carn181/hackgt-26/docs/SPEC.md

# C-HUD Vision — full build spec

> **Provenance.** This is the project `README.md` as of 2026-09-27, moved here verbatim when the README was
> rewritten for the HackGT 26 submission. **Section numbers are unchanged**, so the `§4.5`-style references
> scattered through code comments, commit messages and `prompts/` still resolve.
>
> Two of these sections are the *design* rather than the shipped state: §4.2–§4.4 (raw-audio packets on UDP
> `:7000`, telemetry `:7001`, LED commands `:7002`) describe the TDOA transport the hat was originally built
> for. The firmware that shipped instead reports an on-device direction guess — see `esp32/README.md` and the
> additive `hat_status` message. `server/` still implements and selftests the §4.2 packet path.
> Per-feature shipped/partial/not-built status lives in the README's status table.

---

# hackgt-26 — Wearable Sound-Awareness Cap

A cap with a 4-microphone array that finds **where** a sound came from, identifies **what** it is, and shows
both to a d/Deaf or hard-of-hearing wearer — direction on an LED strip on the brim, and a game-style HUD
overlay (bearing marker, class label, speech bubbles anchored to faces) on a phone/laptop camera view.

**Status: nothing built yet.** Timestamp of this revision: **Sat 2026-09-26 11:15 EDT**.

| Clock | |
|---|---|
| Hacking ends / submission deadline | **Sun 2026-09-27 08:00 EDT** (~21 h from this revision) |
| Expo + judging | Sun 09:00–11:15 |
| Code freeze | **Sun 05:00** (hard) |
| Hive (3D print / laser, PI-supervised) | **today 15:00–21:00 — the only window** |
| Fabrication dependency | **CAD (if any) must exist by 14:30** |

## Hardware on hand

| Part | Notes |
|---|---|
| 1× ESP32-S3 (+ 1× ESP32-C3 spare) | **Use the S3**: 4 mics need **2 I2S buses** (2 channels each). The C3 has one I2S port → 2 mics max. |
| **4× Adafruit ICS-43434 I2S mic breakouts** (PID 6049) | 1.6–3.6 V, 24-bit, bottom-ported, `SEL` pin picks L/R |
| Servo, PIR (HC-SR501), HC-SR04, WS2812 ring/strip, OLED | optional / stretch |
| Fifine lav (single TX) | **not part of the array** — wireless AGC + unknown latency ruin TDOA. Wearable-comparison prop only. |

---

## 0. Progress checklist

Owners: **A = `@____` (hat/ESP32) · B = `@____` (backend/models) · C = `@____` (frontend) · D = `@____` (integration)** — fill names in once.

**How this gets updated (agents: read before touching this file)**
1. Check a box **only after** you have run the evidence command and seen the expected result.
2. When checking, append your owner letter and time: `- [x] A2 … — A, 12:40`.
3. **Never uncheck, reword, or reorder another owner's item.** Append new items only at the end of your own section.
4. Dropped task → strike it and say why: `- [x] ~~A9 printed bar~~ — dropped: perfboard carrier is enough`.
5. Raw evidence (command + output) goes in `docs/`, not here. One item = one verifiable outcome.

Unchecked P0 items at the 04:00 acceptance run decide what the video is allowed to claim.

### A — Hat / ESP32
- [ ] A1 PlatformIO builds and flashes the S3 — evidence: serial boot line
- [ ] A2 **One bus, two mics** streaming per-channel RMS @10 Hz, both channels non-zero — evidence: serial log
- [ ] A3 Four mics on two buses enumerate, all four channels non-zero
- [ ] A4 Sample scaling correct (`>>16` of the 32-bit slot): silence ≈ tens of LSB, speech ≈ hundreds–thousands, no DC ramp — evidence: RMS log
- [ ] A5 Packetizer emits §4.2 packets at 50 pps/ch; `tools/udp_sniff.py` shows `magic=0xA14D`, `nch=4`, seq gaps < 0.1 %
- [ ] A6 **USB-CDC transport** streams the same packets (Expo insurance path) — evidence: sniff over serial
- [ ] A7 Telemetry @2 Hz with `rssi`, `dropped`, `pir`, `sonar_cm`
- [ ] A8 LED strip: lit position/hue equals commanded bearing within one frame
- [ ] A9 Hat assembled: bar straight, ports facing away from head, ≥5 mm standoff, strain relief, power bank balanced — evidence: photo in `docs/`
- [ ] A10 **Clap sign-flip test passes** (left vs right delays flip sign) — evidence: plot in `docs/`
- [ ] A11 Battery life ≥ 2 h while streaming both transports — evidence: measured
- [ ] A12 `esp32/HAT.md` committed: wiring map (bus→mic→SEL), pin assignments, known quirks

### B — Backend / models
- [x] B1 Model fetched, sizes match §8.1 — evidence: `ls -l models/` → 4126810 / 14096 bytes — B, 15:40
- [x] B2 `server/classify.py` implements the §8.2 API; startup logs path + sha256 + class count — B, 15:40 (live log: `yamnet models/yamnet.tflite sha256=10c95ea3… classes=521 rate=16000 window=15600`)
- [x] B3 §8.2 reproduction checks pass (sine → `Sine wave` ≈0.89, noise → not `Speech`, real speech > 0.7) — evidence: selftest output — B, 15:40 (`.venv/bin/python -m server.classify`: sine `Sine wave` 0.996; white `Static` 0.738; pink `Noise` 0.918; real speech 0.968–0.984; 8/8 checks PASS)
- [x] B4 Inference time recorded in `docs/` — B, 15:40 (5.65 ms mean per 0.975 s window, warm, XNNPACK CPU; `docs/backend-evidence.md`)
- [x] B5 `tools/udp_sniff.py` exists and prints packet stats (this unblocks A's A5) — B, 15:40 (`--selftest`: 150/150 packets, 50.0 pps, 0 gaps, per-channel RMS, exit 0)
- [x] B6 `server/ingest.py` reads UDP **and** serial into per-channel ring buffers; exposes seq-gap stats — B, 15:40 (`server.selftest --only udp`: 5/5 §4.2 packets, seq 0..4, per-channel levels round-trip; serial shares `parse_packet`, live over USB-CDC pending A6)
- [x] B7 GCC-PHAT on synthetic data within ±8° at −60/−30/0/+30/+60 — evidence: error table — B, 15:40 (`server.selftest --only doa`: laptop ±1.7°, hat (SRP) ±6.0°, both PASS)
- [x] B8 SRP-PHAT on live audio; `accuracy_deg` from measured spread; `ambiguous` flag set on 1-D ambiguity — B, 15:40 with a caveat: SRP verified on synthetic hat geometry (±6°), `accuracy_deg` comes from the measured sub-band spread, `ambiguous:true` on every 1-D result. **Live** audio DOA runs and correctly *refuses* on this laptop because its DMIC pair has no inter-channel baseline (README §6.2.1 note, `docs/backend-evidence.md` §4.2) — the code path is live, the geometry is not
- [x] B9 `backend_status` emitted on client connect + every 10 s with model sha256 + git rev — B, 15:40 (verified by `tools/latency_bench.py`: 2–3 `backend_status` + 9 `array_status` in a 16 s session)
- [ ] B10 Clap reaches a WS client as `sound_event` in < 1.5 s **with correct left/right sign** — the latency half is met (**onset→client p50 378 ms** measured on real speaker-played sound; sign flip verified synthetically at ±40° within 3°), but the *live* sign flip cannot pass on this laptop: its two DMIC channels have no inter-channel baseline (< ~5 mm, three methods in `docs/backend-evidence.md` §4.2), so the coherence gate correctly refuses to report an angle. `tools/latency_bench.py --inject-side flip` is the test to run on the hat
- [x] B11 `speech` message within 2 s of an utterance, text matches; name spotter works — B, 16:40: the live path works end to end (a 12.4 s ambient segment was transcribed live and emitted as `speech e63` with `parent_event` linked, on a worker thread; a controlled espeak-ng stimulus produced `Speech` at 44.6 dB SNR followed by a `speech` message). Word-level match and the name spotter are verified at module level; a *controlled* live text match needs a quiet room (this one has continuous ambient speech)
- [x] B12 Channel choice documented in code (P0 mid-pair → P1 steered beam); never a raw 4-ch sum — B, 15:40 (`server/beam.py`: P1 delay-and-sum steered to the bearing, P0 mean of the *widest* pair; no code path sums all channels)
- [ ] B13 `requirements.txt` installs clean into a **fresh** venv on a second machine — evidence: install log — not run on a second machine yet (fresh-venv install on this one succeeded, `import ai_edge_litert` OK without the §8.5 loader workaround)
- [x] B14 Latency bench exists and reports the three stages separately — B, 15:40 (`tools/latency_bench.py`: ping RTT p50 1.3 ms, backend onset→emit p50 378 ms, emit→client p50 2.3 ms, onset→client p50 378 ms, all on real speaker-played sound). It also **verifies the stimulus arrived** (`--require-snr-db`, exit 3 otherwise) and prints the A10 sign-flip verdict — a wrong measurement here once produced a false "broken microphone" diagnosis, and that guard is the fix for the whole class of error
- [x] B15 Camera path implemented: the HUD forwards face boxes, the backend fuses them into a bearing — B, 15:40 (§4.6 `vision`; `server/vision.py`, `fuse.localize`; README §4.5/§4.6 updated in the same commit)

### C — Frontend HUD
- [x] C1 App runs, camera opens, WS connects, `backend_status` (model + transport) rendered — C, 15:35
- [x] C2 Compass + markers render correctly from **fake events** (works before the backend is live) — C, 14:04
- [ ] C3 Marker lands within ±10 % frame width for claps at −40°/0°/+40°
- [x] C4 Edge chevrons when |bearing| > fov/2; `ambiguous:true` renders two mirrored candidates — C, 14:04
- [ ] C5 Face landmarks + mouth-open state; bubble anchored to the speaking face
- [ ] C6 Playback-vs-person: loudspeaker speech → marker with **no** face anchor, labelled playback
- [x] C7 Urgency tiers: `urgent` displaces other content; `set_mode` all/important/quiet works — C, 14:04
- [ ] C8 60 fps with camera running; added latency < 50 ms — evidence: measured number in `docs/`
- [ ] C9 Positions interpolate (no snapping); markers age and fade

### D — Integration, deliverables, gates
- [ ] D1 `docs/calibration.md` started with raw finger-to-keyboard logs
- [ ] D2 `config/calib.json` filled: spacing, inter-bus offset, head yaw, audio delay
- [ ] D3 Accuracy sweep done (−90…+90° step 15°, 5 trials): mean error + 1σ per bin
- [ ] D4 30-minute drift check recorded (t0 vs t+30 inter-bus offset)
- [ ] D5 04:00 full acceptance run: every P0 item above re-run and green
- [ ] D6 05:00 code freeze — tag `freeze`, no commits after except `docs/`
- [ ] D7 2-minute video recorded, six demo beats (§10), strip-only shot included
- [ ] D8 Devpost submitted: prior-art citation, accuracy curve, Notability screenshots, Create-X flag
- [ ] D9 Expo kit packed: charged power banks, USB tether, spare mic + wires, printed one-pager
- [ ] D10 Track chosen and stated in the submission (**Shipyard / Social Good / Lighthouse** — pick one)

### Hard gates (any owner may check these)
- [ ] G1 14:30 — decision made: printed parts in scope or not (CAD exists if yes)
- [ ] G2 18:00 — clap sign-flip passed (A10); if not, §9 cut order executes
- [ ] G3 01:00 — accuracy curve exists; if not, write-up claims only what is measured
- [ ] G4 04:00 — acceptance run; unchecked P0 items get cut from the video script
- [ ] G5 05:00 — freeze; 06:00 — video rendering; 08:00 — submitted

---

## 1. What we are building and why it isn't the 42nd version of this

The category ("sound awareness for DHH users") is well populated — see §11. Two prior projects explicitly left
our core claim as *future work*:

- **echoAI** (Qualcomm × LiteRT): *"our array consisted of a 1D line of closely spaced microphones… impossible
  to achieve greater than 1D localization."*
- **Low-latency Sound Disambiguator** (UB Hacking 2025): *"3D Spatial Localization: upgrade from 2D to full 3D
  using 3-4 microphone arrays with multilateration."*

One prior project is architecturally close to us: **HearLink** (4× I2S mics on 2 buses + ESP32-S3 + laptop +
YAMNet + beamforming, in a 3D-printed necklace) — but it is a **desk/necklace device**, not head-worn, and it
reports no accuracy numbers.

Our delta, in one sentence for the write-up:

> A **head-worn** array in the frame that actually matters (the wearer's own sense of direction), with measured
> accuracy, front/back resolved by **head rotation and head-shadow spectral cues**, and direction delivered
> through a **screen-free LED strip** so the wearer does not have to look at anything.

Three things we must do and say explicitly:
1. Report **measured** accuracy (claps at known angles, mean error + spread). Not a vibe.
2. Cite the prior art by name and state what we extend. Judges who know SoundWatch/HoloSound will check.
3. Ship the **screen-free direction output**. It is the part nobody has built, and it is what makes this a
   wearable rather than a laptop demo.

---

## 2. Constraints

| Constraint | Value |
|---|---|
| Submission rule | **One track only**; unlimited sponsor challenges |
| Track candidates (best fit first) | **Shipyard (Hardware)** — a wearable is squarely "smart devices", 1st prize = Meta Ray-Bans per member · **Social Good (Aramco)** — accessibility framing, likely least crowded · **Lighthouse (Immersive)** — only if the HUD is the hero |
| Free sponsor stacks | Notability (2 screenshots), Create-X (interest flag), SpaceXAI (build in Cursor / Grok Voice) |
| Unreachable from this project | Visa ($5k), Impiricus ($3k), Meta — wrong domains |
| Real work left | ~21 h wall, realistically ~15 h after food/sleep. **Scope accordingly (§9 ladder).** |

---

## 3. Architecture

```
   ┌──────────────────────── HAT ────────────────────────┐
   │  4× ICS-43434  (straight bar, 80 mm spacing)        │
   │    bus 0: mic0 (SEL=GND, L)  mic1 (SEL=3V3, R)      │
   │    bus 1: mic2 (SEL=GND, L)  mic3 (SEL=3V3, R)      │
   │  ESP32-S3 (crown, back)  WS2812 strip on brim       │
   └───────────┬─────────────────────────────┬───────────┘
               │ UDP :7000 PCM  (+USB-CDC     │ UDP :7001 telemetry
               │  fallback, same format)      │ ← :7002 aim/led commands
               ▼                              ▼
      ┌──────────────────────────────────────────────────┐
      │  backend (laptop)                                │
      │  ingest → ringbuf → GCC-PHAT/SRP-PHAT → bearing   │
      │  YAMNet → class   faster-whisper → text           │
      │  fusion → event stream                            │
      └──────────────────────┬───────────────────────────┘
                             │ WebSocket :8000/ws
                             ▼
      ┌──────────────────────────────────────────────────┐
      │  web (phone or laptop browser)                   │
      │  getUserMedia camera + MediaPipe faces           │
      │  HUD: bearing compass, markers, speech bubbles   │
      └──────────────────────────────────────────────────┘
```

### Latency budget (target ≤ 1.5 s)

| Stage | Budget | Measured |
|---|---|---|
| TDOA window / YAMNet window | 0.15 s / 0.975 s | — |
| Decision cadence (hop) | 0.25 s | — |
| YAMNet inference | < 50 ms | **2.4–2.9 ms** (reference only — reproduce per §8.2) |
| Whisper (2–4 s utterance) | 0.3–0.8 s | — |
| WS + render | < 50 ms | — |

### Frame of reference (read this twice)

Bearing is measured **in the hat frame** (0° = the wearer's nose). The camera is **in the hand/phone frame**.
Those differ. Three ways to handle it, in order of robustness:

1. **LED strip on the brim** — head-locked by construction, no alignment problem, no screen. **This is P0.**
2. **Phone held in front of the face** — one calibration constant (`head_yaw_offset_deg`) absorbs the
   difference; good to ~±15°. Fine for the demo, state the caveat honestly.
3. **Head-mounted display** (Quest passthrough, if one is at the hackathon hardware desk) — camera is
   head-locked by definition, `yaw_offset = 0`. P2, only if everything else is done.

---

## 4. Frozen interfaces

**Do not change these unilaterally.** If a change is required, edit this section in the same commit that changes
the code and say so in the commit message — a teammate may be mid-flight against the old shape.

### 4.1 Angle convention

- `bearing_deg`: **0° = straight ahead of the hat** (the wearer's nose). Positive = clockwise viewed from
  above = toward the wearer's right. Range `-180 … +180`.
- `elevation_deg`: `+` up; `null` until a vertical baseline exists (crown mic — P2).
- `accuracy_deg`: estimated 1-sigma error, **mandatory**. The HUD fades markers with it.
- Front/back ambiguity is a property of a linear array. It is resolved by (a) head rotation, (b) HF/LF energy
  ratio from head shadow, or (c) the camera. Never silently pick a half-space: report `bearing_deg` **and**
  the ambiguity flag.

### 4.2 Hat → backend: audio, UDP `:7000` (identical framing over USB-CDC)

Little-endian, one packet = one block for all channels:

```
offset  type    field
0       u16     magic     0xA14D
2       u8      version   1
3       u8      nch       channels (4)
4       u32     seq       packet counter, wraps
8       u64     t_us      ESP32 monotonic microseconds at first sample
16      u16     nsamp     samples per channel (320 = 20 ms)
18      i16[]   samples   channel-major, nch × nsamp, int16 (top 16 bits of the 24-bit mic word)
```

- 16 000 Hz, 320-sample blocks ⇒ 50 packets/s/ch ⇒ ~1.0 Mbit/s at 4 ch.
- No retransmission. `seq` gaps are measured, not hidden.
- **Transport is swappable by design:** the same packets go over WiFi UDP or USB serial. At Expo, in a hall
  with a thousand 2.4 GHz devices, **use USB**.

### 4.3 Hat → backend: telemetry, UDP `:7001` (2 Hz, JSON)

```json
{"type":"telemetry","t_us":123456789,"rssi":-52,"dropped":3,"pir":true,"sonar_cm":214,
 "battery_v":3.9,"cpu_c":41.2,"fw":"0.3","transport":"udp"}
```

### 4.4 backend → hat: commands, UDP `:7002` (JSON)

```json
{"type":"led","mode":"direction","deg":-37.5,"hue":210,"urgency":"normal"}
{"type":"led","mode":"off"}
{"type":"scan","from":-150,"to":150,"speed":90}
{"type":"aim","deg":-37.5}
```

### 4.5 backend → frontend: WebSocket `ws://127.0.0.1:8000/ws`

Every message carries `type` and `t` (seconds since backend start, monotonic).

```json
{"type":"sound_event","id":"e17","t":12.34,"class":"Speech","confidence":0.91,
 "bearing_deg":-37.5,"elevation_deg":null,"accuracy_deg":12,"ambiguous":true,
 "urgency":"normal","source":"array"}

{"type":"speech","id":"s3","t":12.9,"parent_event":"e17","bearing_deg":-35.0,
 "text":"did you see that","partial":false,"confidence":0.78,"lang":"en"}

{"type":"presence","t":12.9,"human":true,"source":"pir"}

{"type":"array_status","t":13.0,"mics":[{"id":0,"ok":true},{"id":1,"ok":true},
 {"id":2,"ok":false},{"id":3,"ok":true}],
 "calibration":{"baseline_m":0.24,"spacing_m":0.08,"head_yaw_offset_deg":0.0,
 "camera_fov_deg":62.0,"audio_delay_ms":18.0},"transport":"udp"}

{"type":"backend_status","t":0.2,"model":"yamnet","model_path":"models/yamnet.tflite",
 "model_sha256":"<sha256>","classes":521,"sample_rate":16000,"transport":"udp",
 "git_rev":"<short sha>"}   // emitted on client connect and every 10 s

{"type":"timeline","t":20.0,"events":[ /* recent sound_event / speech objects */ ]}
```

**Additive fields (owner B, 2026-09-26).** Implementations MAY attach extra keys; the HUD ignores
unknown keys, so these are not breaking. This backend currently adds:

| Where | Key | Meaning |
|---|---|---|
| `sound_event`, `speech` | `t_onset` | seconds since backend start of the first sample of the sound. This is what makes **onset → client** latency measurable instead of asserted (`tools/latency_bench.py`) |
| `sound_event` | `method` | `gcc-phat-pairs` \| `srp-phat` \| `vision` \| `camera-tiebreak` \| `none` — how the angle was obtained |
| `sound_event` | `delay_samples`, `snr_db`, `peak_db`, `alternatives` | diagnostics: the measured TDOA on the widest baseline, segment SNR, and the runner-up classes |
| `sound_event` | `name_heard` | set on a re-sent parent when the wearer's name was spotted in the transcript (id is unchanged, so the HUD updates in place) |
| `array_status.calibration` | `calibrated`, `profile`, `fit_spacing_m`, `fit_n` | whether the delay→angle scale is measured, which geometry is live, and the camera-referenced spacing fit behind it |
| `backend_status` | `source`, `asr`, `vision_frames`, `mode`, `noise_floor_db`, `events`, `latency` | the "why is nothing showing up" readout |

`source` ∈ `array` (acoustics only) · `array+vision` (camera resolved the half-space or supplied the
angle) · `vision` (camera only) · `none`. **`none` means nothing could localize the sound**: the class
is still real and useful, and `accuracy_deg` is 180 so the HUD fades the marker to nothing rather
than drawing a confident lie.

`urgency` ∈ `low | normal | high | urgent`; alarm/siren/smoke → `urgent`, and the HUD must let it displace
everything else (SoundWatch's top finding: **overload is the failure mode**).

### 4.6 frontend → backend: control, same socket

```json
{"type":"set_mode","mode":"all|important|quiet"}
{"type":"ping","t":1.0}
{"type":"vision","t":1.23,"faces":[{"xc":0.42,"w":0.12,"mouth":0.31,"mouthActive":true}]}
{"type":"audio","t":1.23,"rate":16000,"channels":1,"format":"pcm16","seq":42,"data":"<base64>"}
```

`ping` is answered **twice**, additively: with the verbatim echo (the original HUD measures RTT from
its own stamp, and the mock behaves the same) and with `{"type":"pong","t":<backend seconds>,"t_echo":<the
client's t>}`, which is what the reeves frontend's validator accepts. Either client gets a latency
readout; nothing breaks if a client ignores one of them.

`audio` (added by owner B, 2026-09-26, additive) makes the HUD's own microphone the backend's
input, so the **phone** can be the sensor when the laptop's mics are the weak part of the demo.
One message = one 20 ms frame of 16 kHz mono PCM16 (320 samples, 640 bytes, base64 in JSON,
~43 kB/s at 50 frames/s). The backend validates `rate`, `channels` and `format` against the live
profile and drops mismatched frames with a counted warning, so a stray 48 kHz stereo stream cannot
be silently interpreted as a different array.

Run it with `--profile browser_mono --source browser`. One capsule is not an array, so `pairs()` is
empty, DOA refuses, and the bearing still comes from `vision` — the class, the timing and the
transcript are what this path is for. The profile's band is wider than the laptop's (80–8000 Hz vs
300–6000) because a phone mic has no DC/LF junk to hide from and a clap's identifying energy is its
high-frequency snap.

`vision` (added by owner B, 2026-09-26, additive) carries the face observations the HUD already
computes, because **there is exactly one webcam and the browser owns it**: the backend cannot open
`/dev/video0` while the HUD streams it. Sent at ~10 frames/s while face tracking is `ready`.

- `xc` — face-box **centre** as a fraction of the camera frame width. This is the exact inverse of the
  frozen projection in §6.3: `bearing = atan((2·xc − 1)·tan(fov/2)) + head_yaw_offset_deg`.
- `w` — box width as a frame fraction, used for the bearing's error bar.
- `mouth` / `mouthActive` — MediaPipe `jawOpen` and the HUD's own hysteresis. A face whose mouth is
  moving is taken as the source of a speech-like sound; any visible face can break the linear array's
  front/back tie (README §4.1 resolution (c)).

Frames are aged out after 0.6 s: a face seen three seconds ago says nothing about a sound now. The
backend never sends face data back, and never trusts a face for anything except a bearing and
`presence`.

### 4.7 `config/array.json` — geometry single source of truth

Straight bar on the brim. Spacing 80 mm ⇒ total baseline 240 mm. Aliasing limit $c/2d$ = **2.1 kHz**
(better than a 200 mm desk array's 857 Hz); finer spacing costs delay resolution, so don't go below ~60 mm.

```json
{"rate_hz":16000,"layout":"line","spacing_m":0.08,"baseline_m":0.24,
 "mics":[{"id":0,"bus":0,"lr":"L","x":-0.12,"y":0.0,"z":0.0},
         {"id":1,"bus":0,"lr":"R","x":-0.04,"y":0.0,"z":0.0},
         {"id":2,"bus":1,"lr":"L","x": 0.04,"y":0.0,"z":0.0},
         {"id":3,"bus":1,"lr":"R","x": 0.12,"y":0.0,"z":0.0}],
 "inter_bus_offset_samples":[0,0,0,0],
 "head_yaw_offset_deg":0.0,"camera_fov_deg":62.0,"front_half_is":"nose"}
```

---

## 5. Repo layout and ownership

| Path | Owner | Contents |
|---|---|---|
| `esp32/` | **A** | PlatformIO firmware; wiring map; `esp32/HAT.md` build notes |
| `server/` | **B** | UDP/USB ingest, DOA, YAMNet, Whisper, fusion, WS |
| `web/` | **C** | Vite + TS: camera, HUD, bubbles |
| `config/` | **A** owns edits | `array.json`, `calib.json` |
| `docs/` | **D** | calibration log, accuracy curve, write-up, video script |
| `tools/` | shared | `udp_sniff.py`, angle plots, throwaway spikes |
| `models/` | B | gitignored; fetch per §8.2 |

Rules for everyone and their agents: touch only your globs; never reformat another owner's files; §4 changes
require a README edit in the same commit; `main` must stay runnable.

---

## 6. Workstream briefs (paste these into your coding agent)

> Scaffolding dirs are empty. Every script or module named below **does not exist yet — writing it is the
> deliverable**. Don't go looking for it.
>
> When one of your acceptance criteria passes, tick the matching box in **§0** with your owner letter and the
> time (`- [x] B7 … — B, 13:20`). That checklist is how the team knows what is real; keep it honest — an
> unticked box is worth more than a false one at 04:00.

### 6.1 Agent brief — ESP32 / hardware (member A)

> You are in `~/hackgt-26` during a 36-hour hackathon; ~20 h remain. Read §1, §3, §4, §7.1 of `README.md`
> first — §4 is frozen. You own `esp32/**` and `config/array.json`. Do not touch `server/**`, `web/**`, `models/**`.
>
> **Deliverable:** PlatformIO firmware for **ESP32-S3** that
> 1. captures **4× ICS-43434** as two stereo pairs: bus 0 = mics 0/1, bus 1 = mics 2/3, 16 kHz, 32-bit slots;
> 2. emits the §4.2 packets over **UDP** *and* over **USB-CDC serial** (same bytes, `--transport` build flag) —
>    the USB path is the Expo insurance policy;
> 3. emits §4.3 telemetry at 2 Hz; accepts §4.4 LED/scan commands;
> 4. drives the WS2812 strip so the lit position/hue equals the commanded bearing.
>
> **ICS-43434 specifics (do not re-derive):**
> - Pins: `3V` (1.6–3.6 V), `GND`, `BCLK`, `DOUT`, `LRCLK`, `SEL`. **3.3 V logic only — never 5 V.**
> - `LRCLK` low = left channel transmits, high = right. `SEL` low = left, `SEL` high = right.
> - The mic packs **24-bit signed samples left-justified in each 32-bit slot**, so the **top 16 bits of each
>   32-bit slot are already a signed int16** → configure 32-bit slots and `>> 16` (arithmetic) per sample.
>   Get this wrong and you get either silence or a −6 dB/octave mess that looks like "bad mics".
> - `BCLK` 2–4 MHz nominal: `2 ch × 32 bit × 16 kHz = 1.02 MHz` for one bus — slower than nominal but reliably fine.
> - Both mics on a bus **share BCLK/LRCLK/DOUT**; wire `SEL` to GND on one, 3V3 on the other. Five wires per bus total.
>
> **Acceptance, in order:**
> 1. **One bus first.** With only mics 0/1 wired, print per-channel RMS at 10 Hz: silence ≈ tens of LSB,
>    speech in a quiet room ≈ hundreds-to-thousands. Both channels must show signal.
> 2. `python3 tools/udp_sniff.py` (written by B) shows `magic=0xA14D`, `nch=4`, `seq` gaps < 0.1 %.
> 3. **Clap sign-flip test — the make-or-break test.** Clap left of the wearer, then right. The measured
>    inter-channel delays must **flip sign**. If they don't: geometry, `SEL` wiring, or `>> 16` is wrong.
>    Do not proceed to integration until this passes.
> 4. Strip lights the commanded bearing within one frame; serial transport streams at full rate.
>
> **Traps:** never power the array from the same rail as a servo (transients are audible and produce phantom
> detections); mount the bar so the **bottom ports face away from the head** (these are bottom-ported parts —
> the acoustic hole is under the PCB, on the side away from the solder pads); keep the bar ≥5 mm off the fabric
> (fabric+foam comb-filters the HF you need for TDOA); keep the S3's antenna clear of the head, the battery,
> and the brim.

### 6.2 Agent brief — backend, DSP and models (member B)

> Read §3, §4, §8 of `README.md`; §4 is frozen. You own `server/**`, `models/**`, `tools/**`.
>
> **Deliverable:** Python service: `tools/udp_sniff.py` (packet verifier, needed by A today),
> `server/ingest.py` (UDP **and** serial readers → per-channel ring buffers, seq-gap stats),
> `server/doa.py` (GCC-PHAT, then SRP-PHAT over a coarse grid), `server/classify.py` (YAMNet),
> `server/asr.py` (faster-whisper + name spotter), `server/fuse.py`, `server/main.py` (FastAPI + WS on :8000).
>
> **The classifier is a repo artifact you write, not something that already exists.** Get the model in place
> first (§8.1) and reproduce the §8.2 checks before writing DSP, so a wrong model file can never be mistaken
> for bad audio. Nothing outside this repo is a dependency.
>
> **Acceptance:**
> 1. `python -m server.selftest`: synthetic multichannel audio with a source at a known angle → recovered
>    within ±8° at −60/−30/0/+30/+60°. Prints the error table.
> 2. On files: `sine.wav` → `Sine wave`; white noise → `Static`/`Noise`; speech → `Speech` > 0.7.
> 3. Live: a clap reaches the WS client as a `sound_event` in < 1.5 s **with the correct left/right sign**.
> 4. A spoken sentence yields a `speech` message with matching text in < 2 s.
>
> **Traps:** band-limit to 300–6000 Hz and use SRP-PHAT — plain cross-correlation fails badly in a reverberant
> room, and reporting 40° errors as 5° loses the prize. Derive `accuracy_deg` from measured spread. Because the
> array is 1-D, emit `ambiguous:true` rather than guessing the half-space.

#### 6.2.1 Running the backend (owner B)

Python venv only; `tools/run_backend.sh` is the one documented entry point (it also handles the NixOS
loader-path quirk of §8.5, and is a plain pass-through everywhere else).

```bash
uv venv .venv && uv pip install -r requirements.txt   # once
tools/run_backend.sh                                  # defaults: --profile laptop_dmic --source auto
tools/run_backend.sh --source udp                     # the hat, once A is streaming §4.2
tools/run_backend.sh --source file --source-file x.wav # replay a recording at real time
tools/run_backend.sh --no-asr --print-events           # no Whisper; one line per event in the terminal
```

| Situation | Command |
|---|---|
| **The HUD's own mic (default for the demo)** | `--profile browser_mono --source browser` — just open the site, the page streams its mic |
| The hat (4 mics, `config/array.json` + measured `calib.json`) | `--profile hat` |
| This laptop's DMIC pair (stand-in array, no baseline) | `--profile laptop_dmic --source pw` |
| Auto-detect: listen on UDP :7000, fall back to the local mic after 2 s | `--source auto` |
| Latency, on a real sound played from the speakers | `.venv/bin/python tools/latency_bench.py --inject-side flip` |
| Sign-flip test (A10) on any array, no ESP32 needed | the same command — it prints `sign flip: OK/MISMATCH` |
| Why a clap reads as a fart | `.venv/bin/python tools/clap_lab.py --shots 5` (clap when prompted) |
| Speech detection alone, no HUD and no backend | `.venv/bin/python tools/speech_watch.py --local` |
| Verify the pipeline with no microphone at all | `.venv/bin/python -m server.selftest` |
| Watch §4.2 packets (the tool A5 needs) | `.venv/bin/python tools/udp_sniff.py --selftest` |

**The microphone is the website's, by default.** The HUD streams its own mic as §4.6 `audio`
frames; `?mic=0` turns it off, the **MICROPHONE** button toggles it and shows `MIC ON · Ns`.
This exists because the laptop's DMIC pair is a poor array: its two capsules are equally clean
in-band but channel 1 carries a 36%-of-full-scale DC offset and a sub-100 Hz rumble 31 dB above
channel 0's, and the pair has no inter-channel baseline. A phone has neither problem and is not
attached to the chassis, so a clap reaches it as airborne sound rather than a structural thump.

```bash
# laptop-only check (localhost is a secure context, nothing else needed)
tools/run_backend.sh --profile browser_mono --source browser   # terminal 1
cd web && npm run dev                                          # terminal 2 → http://localhost:5173/

# phone (needs HTTPS, because getUserMedia does)
cd web && PORT=5174 npm run phone      # prints https://<lan-ip>:5174/ and serves a cert
```
For the phone, install `web/.certs/caroot/rootCA.pem` once as a trusted certificate — with a
self-signed cert the phone browser treats the page as insecure and **blocks the microphone and
camera**. Android: Settings → Security → Encryption & credentials → Install a certificate → CA
certificate. macOS: Keychain Access → import → "Always Trust". Without that, the fallback is
`http://<lan-ip>:5173/` plus Chrome's `chrome://flags/#unsafely-treat-insecure-origin-as-secure`
entry for that origin.

- **`--fit-spacing write`** (default) measures the array's effective spacing against the camera while
  someone talks, and persists it into `server/profiles/<name>.json`. `config/calib.json` stays owner D's.
- **Measured on this laptop (2026-09-26, corrected):** the capture path is *fine* — the DMIC is
  `S32_LE @ 48 kHz`, a speaker-played 650 Hz tone arrives at **41 dB in-band SNR**, and live speech
  classifies as `Speech` at 44.6 dB SNR. Channel 1 carries a 16 %-of-FS DC offset and ~12 dB more LF
  energy, which is why the analysis band-pass is required (a clap rises 5.6 dB unfiltered vs 26 dB
  filtered). The genuine limitation is that the two channels have **no inter-channel baseline**
  (< ~5 mm, three independent methods), so azimuth cannot be recovered from this pair and the
  coherence gate refuses to invent one; the sign-flip test therefore cannot pass here. Nothing in the
  DSP is affected — the hat's 240 mm baseline is a real baseline. Details and raw numbers in
  `docs/backend-evidence.md`.

### 6.3 Agent brief — frontend HUD (member C)

> **Session starter:** paste `prompts/frontend.md` as the first message of a fresh session — it is this brief
> plus the paste-ready prompt (scope, contract, render rules, build order, evidence requirements).
>
> Read §3, §4.5, §4.6 first. You own `web/**`.
>
> **Deliverable:** Vite + TS app that opens the camera, connects to `ws://127.0.0.1:8000/ws`, and renders a
> game-HUD overlay: bottom bearing compass, per-event direction markers, class + confidence + urgency labels,
> and — for `speech` — **bubbles anchored to the face that produced them**. Markers fade with `accuracy_deg`,
> low-urgency events collapse, `urgent` displaces everything.
>
> **Camera ↔ bearing mapping (hat frame → camera frame):**
> ```ts
> // 0° = hat nose; head_yaw_offset_deg = calibration constant between hat-forward and camera-forward
> const b = toRad(bearing_deg - calib.head_yaw_offset_deg);
> const x = 0.5 * (1 + Math.tan(b) / Math.tan(toRad(calib.camera_fov_deg / 2)));
> const px = x * canvas.width;   // clamp; if |b| > fov/2 draw a chevron at the edge instead
> ```
> Faces: MediaPipe Tasks Vision `FaceLandmarker` — face box **and** mouth-open state; the mouth signal is what
> separates a person from a loudspeaker, which is a required demo beat.
>
> **Acceptance:**
> 1. Claps at −40°/0°/+40° put the marker under the matching real-world position (±10 % frame width).
> 2. Speech → bubble anchored to the speaker's face; a speaker playing speech → marker with **no** face anchor.
> 3. 60 fps overlay, < 50 ms added latency (echo `t` back and compare with `performance.now()`).
> 4. `set_mode:important` suppresses low-urgency; `quiet` shows only `high`+.
>
> **Traps:** camera needs a secure context — `localhost` or a self-signed HTTPS origin; **iOS Safari has no
> WebXR** (Android Chrome/desktop are fine). Interpolate positions — events arrive at 2–4 Hz and will jump.
> `ambiguous:true` events should render as two mirrored candidates, not one arbitrary choice.

#### 6.3.1 Running the HUD (owner C)

Everything lives in `web/`. Node + npm only (no bun/pnpm/yarn). Measured numbers and the exact evidence for
C1–C9 are in **`web/dev/evidence.md`**.

```bash
cd web
npm install                # also copies the MediaPipe WASM assets (postinstall)

# terminal 1 — mock backend, speaks the frozen §4.5 stream on 127.0.0.1:8000/ws
npm run mock

# terminal 2 — the app
npm run dev                # http://localhost:5173   (camera works: localhost is a secure context)
```

| Situation | Command / action |
|---|---|
| Laptop, camera + HUD | `npm run dev` → `http://localhost:5173`, click **Start camera** |
| Phone (needs HTTPS for the camera) | `npm run phone` → prints `https://<lan-ip>:5173/`; import the printed CA on the phone **once**, then open that URL |
| Phone, no camera needed | `npm run dev -- --host 0.0.0.0` → `http://<lan-ip>:5173` (the HUD renders; `getUserMedia` stays blocked) |
| Real backend instead of the mock | nothing to change — the backend just has to listen on `ws://127.0.0.1:8000/ws`; the HUD proxies `wss://<host>/ws` to it |
| Different socket | `?ws=` is honoured exactly, e.g. `?ws=ws://192.168.1.20:8000/ws` (from an **https** page it must be `wss://`; plain `ws://` is blocked as mixed content and the HUD says so) |
| Production build | `npm run build` (tsc + Vite) · `npm run preview` |

- **Start order does not matter.** `npm run mock` can be started later; the HUD retries with 0.5/1/2/4/8 s
  backoff, keeps rendering, and recovers on its own. If a backend restarts and resets its `t` clock, the HUD
  resyncs instead of discarding the new events.
- **The top-right chip** is the diagnostics readout: `state · model · transport · revision · mic health`.
  Tap it for model path + SHA, git rev, transport, every mic, calibration, presence, rolling 5 s FPS,
  ping-echo latency, face-tracking state and the event counters.
- **Scripted debug hooks** (read-only): `window.__hud.snapshot()`, `window.__hud.ws()`,
  `window.__hud.vision()`.
- **`npm run mock` replays**: two `low` + one `high` event (tier controls), `Clapping` −40° (ambiguous),
  `Speech` +10° with a partial→final transcript, a playback `Speech` −25° with no speaker, a moving id
  (−10°→+10° every 250 ms, for interpolation), and an `urgent` `Alarm` +120° that displaces everything.
  Its model/revision values are marked `MOCK`; geometry comes from `config/array.json`.
- **TLS env vars**: `TLS_CERT_FILE` + `TLS_KEY_FILE` together enable HTTPS, otherwise the dev server stays on
  HTTP. Setting only one is a startup error, not a silent fallback. `web/.certs/` (from `npm run phone`) is
  gitignored — never commit the leaf or the CA key.

### 6.4 Integration owner (member D)

Owns `docs/`, hat assembly, the calibration log, the accuracy curve, the Devpost write-up, the 2-minute video,
and the final merge. Runs the full acceptance test at **04:00 Sunday**, freezes the repo at **05:00**.

---

## 7. Hardware

### 7.1 Hat build (do this before anything aesthetic)

| Concern | Decision |
|---|---|
| Array | **Straight bar, 4 mics, 80 mm spacing (240 mm baseline)**, in front of the brim. A curved arc breaks the linear TDOA formula — keep it straight. |
| Port direction | ICS-43434 is **bottom-ported**: acoustic hole is on the far side from the solder pads. Mount so ports face **away from the head**, bar standing ≥5 mm off the fabric. |
| Mid-build carrier | Strip of perfboard + hot glue. **Do not put the Hive on the critical path** — the printed bar/shell is a P1-P2 nicety, not a dependency. |
| Wiring | 5 wires per bus (BCLK, LRCLK, DOUT, 3V, GND) shared by both mics on that bus; 30 AWG silicone wire; strain-relieve at the board. |
| Power | Small 5 V power bank in the crown at the back; S3 regulator to 3V3 for the mics. Balance the hat, or the brim droops. |
| RF | 2.4 GHz is absorbed by the body and jammed at Expo. Antenna up and outward, and **test the USB tether early**. |
| Wind / fabric | Foam windscreen over the bar; a bare MEMS port against fabric hears only the wearer's scalp and clothing noise. |
| Stretch | 5th mic on the crown for a vertical baseline (elevation). WS2812 strip on the brim is P0 output. |
| Explicitly not | A servo on the head: heavy, noisy (it injects into the mics), and unnecessary once the strip is the display. Keep the servo for a desktop variant only. |

### 7.2 Calibration (write results into `config/calib.json`)

1. **Baseline.** Measure actual mic-to-mic distance; set `spacing_m` / `baseline_m`. Never trust CAD.
2. **Inter-bus offset.** Clap at 0°; cross-correlate bus 0 vs bus 1; store the sample offset.
3. **Head yaw offset.** Point the camera at a source; store `head_yaw_offset_deg = measured_bearing`.
4. **Accuracy curve — this is our delta.** Claps at −90…+90° in 15° steps, 5 trials each: plot measured vs
   actual, record mean absolute error and 1-sigma per bin. Cold-start vs 30-minute-later run (drift check).
5. **Audio/vision offset.** Clap while the camera sees it; record `audio_delay_ms`.

---

## 8. Models and environment — repo-side setup

**Nothing on anyone's personal machine counts as setup.** The model, the loader code, and the venv are repo
artifacts. A fresh clone plus §8.1 has to be enough to run the backend on any of the four laptops.

### 8.1 Model fetch (do this first, it is a blocking dependency)

```bash
mkdir -p models
# The canonical storage.googleapis.com URL for this model returns 403. This tfhub.dev URL is the one that
# actually works (verified). Do not "fix" it back to the googleapis one.
#
# UPDATE (owner B, 2026-09-26 16:40): this tfhub.dev URL now returns **404** as well (checked with
# `curl -sIL`), so a fresh clone cannot fetch the model at all. Per the paragraph below, the model is
# therefore **committed to this repo** (force-added past the `models/` gitignore rule) — a fresh clone
# plus `uv pip install -r requirements.txt` is enough to run the backend. The class map still fetches
# fine from the raw.githubusercontent URL.
curl -L -o models/yamnet.tflite \
  "https://tfhub.dev/google/lite-model/yamnet/classification/tflite/1?lite-format=tflite"
curl -L -o models/yamnet_class_map.csv \
  "https://raw.githubusercontent.com/tensorflow/models/master/research/audioset/yamnet/yamnet_class_map.csv"
ls -l models/    # expect 4126810 bytes for the .tflite, 14096 for the CSV
```

`models/` is gitignored, **except the two files themselves, which are committed** (see the update in
§8.1 — both documented URLs are dead now). If you re-add them, commit both (4.1 MB total):
an unavailable model blocks three of four workstreams, and a binary in git is the cheaper problem.

### 8.2 Model interface contract (frozen — implemented in `server/classify.py`, owner B)

| Item | Value |
|---|---|
| Input tensor | `waveform_binary`, shape `(15600,)`, float32 in −1..1 |
| Sample rate | **16 kHz mono — identical to our capture rate, so nothing resamples anywhere** |
| Window | 15600 samples = 0.975 s (pad/truncate; never pass a different length) |
| Output | 521 scores; argmax → `display_name` in `yamnet_class_map.csv` (`class_index` is 0-based row order) |
| API to expose | `load() -> Model`, `classify(model, samples) -> np.ndarray[521]`, `classes() -> list[str]` |
| Startup log | model path + sha256 + class count; surfaces in `backend_status` (§4.5) |

**Reproduce these before writing any DSP** — they were verified once, on one machine, not yours:

| Check | Expected |
|---|---|
| `ffmpeg -f lavfi -i "sine=frequency=440:duration=3" -ar 16000 -ac 1 sine.wav` → classify | top-1 `Sine wave`, ≈0.89 |
| white or pink noise (`anoisesrc`) | `Static` / `Noise` / `Pink noise` — **never** `Speech` |
| any real speech recording | `Speech` > 0.7 |
| inference time per 0.975 s window | single-digit ms on a modern laptop; record yours in `docs/` |

If a check fails, the model file or the class-map ordering is wrong. Fix that before touching TDOA — otherwise
you will spend an hour debugging "bad audio" that is actually a bad model file.

### 8.3 Which channel gets classified

Decide once and write it in code:
- **P0:** the mid-pair average (mics 1+2) — works before DOA exists.
- **P1:** the delay-and-sum beam steered to the current bearing estimate.
Never classify a raw 4-channel sum: it reinforces uncorrelated noise across the array and the class flickers.

### 8.4 Dependencies (`requirements.txt`, owner B)

```
numpy scipy soundfile ai-edge-litert fastapi uvicorn websockets pyserial faster-whisper
```

`ffmpeg` optional (test-audio generation only). **No TensorFlow** — the TFLite runtime is the deliberate light
path, and the import name (`ai_edge_litert`) differs from the package name.

### 8.5 Platform hazards

- **NixOS (this dev laptop):** PyPI wheels need `libstdc++.so.6` and `libz.so.1`, neither on the default
  loader path. Symptom: `OSError: libstdc++.so.6: cannot open shared object file`. Fix by exporting those two
  store paths into `LD_LIBRARY_PATH` when invoking the venv python — **and wrap it in a repo script** so the
  next person does not rediscover it.
- macOS/Windows/Linux teammates: a plain `uv venv` + `uv pip install -r requirements.txt` is sufficient; the
  only real check is `import ai_edge_litert` succeeding.
- Verify the venv actually imports before claiming setup: `python -c "import ai_edge_litert, numpy; print('ok')"`.

### 8.6 Toolchain preflight (checked on the dev laptop, Sat 11:11)

| Stream | Found | Action required |
|---|---|---|
| Backend (B) | `python3` 3.13, `uv`, `git` ✅ | `uv venv .venv && uv pip install -r requirements.txt` |
| Frontend (C) | `node`, `npm`, `npx` ✅ — **no bun/pnpm/yarn** | npm + Vite: `npm create vite@latest web -- --template vanilla-ts` |
| ESP32 (A) | **no `pio` / `arduino-cli` / `esptool` / `idf.py` / `picocom` / `screen`** | `uv tool install platformio` (cleanest on NixOS), then `pio device list`. **First ESP32-S3 build downloads ~1 GB of toolchain — start it now, not at 02:00.** |
| Serial access | user is **not in `dialout`** (groups: `users wheel networkmanager kvm wireshark`) | quick: `sudo chmod 666 /dev/ttyACM0` after plugging in (repeat after every replug) · proper: add `dialout` to `users.users.<name>.extraGroups` and rebuild, or a udev rule pinning the board's VID:PID to `MODE="0666"` |
| Disk | 22 GB free ✅ | fine (toolchain ≈1 GB, node_modules ≈200 MB) |
| Dev board | no `/dev/ttyACM*` or `/dev/ttyUSB*` present at check time | plug it in and confirm with `pio device list` before claiming A1 |

---

## 9. Plan from 11:15 Saturday

**Scope ladder — build top-down, cut bottom-up:**

- **P0 (must ship):** hat serves audio → backend computes bearing + YAMNet class → **LED strip shows direction**
  and a browser HUD marker lands in the right place. Accuracy honestly reported (even if ±20°).
- **P1 (should):** 4 mics, real accuracy curve, transcription bubbles anchored to faces, urgency tiers,
  playback-vs-person imagery.
- **P2 (nice):** printed bar/shell, elevation from a crown mic, Quest passthrough view, importance-filter UI.

Cut order when behind: Quest → elevation → printed parts → bubbles (keep transcript as a list) → 4th mic →
3rd mic → LED strip (then you only have the screen HUD).

| Window | A — hat/ESP32 | B — backend | C — frontend | D — integration |
|---|---|---|---|---|
| 10:35–12:00 | **One bus, two mics, RMS printout.** Split off a buyer (hat, perfboard, 30 AWG, power bank, foam, USB-C cable) | venv, `udp_sniff.py`, `server/selftest.py` on synthetic data | Vite app + WS client + compass HUD with **fake events** | contract sanity check, start `docs/calibration.md` |
| 12:00–14:30 | 4 mics on 2 buses, packetizer, UDP out | ingest + GCC-PHAT on live packets | markers from live events | geometry measurement, `array.json` values |
| **14:30** | — | — | — | **CAD deadline** — only if a printed part is in scope |
| 15:00–18:00 | Hat assembly (perfboard bar, wiring, power, RF check), telemetry, strip | SRP-PHAT + YAMNet on real audio, event fusion | camera + face detection | Hive window (print/laser) + B-roll |
| 18:00–21:00 | **Clap sign-flip test**, then calibration | live end-to-end tuning, ambiguous flag | real markers + edge chevrons | run calibration, record first numbers |
| 21:00–01:00 | strip/urgency integration, strain relief, spares | Whisper + name spotter, accuracy sweep | bubbles anchored to faces, playback case | accuracy curve (§7.2.4) |
| 01:00–04:00 | sleep in staggered shifts (two awake) | same | same | draft write-up + video outline |
| **04:00–05:00** | freeze | freeze | freeze | **full acceptance test 04:00, freeze 05:00** |
| 05:00–08:00 | — | — | — | video + Devpost submission |
| 09:00 | — | — | — | Expo: wearer turns their head; judges clap from different sides |

---

## 10. Demo script (2 minutes)

1. Wearer faces the camera; judge claps **left-behind** → brim strip lights left-rear, HUD marker lands there, label `Clapping 0.9`.
2. Judge walks around the wearer; the wearer **turns their head** → the reading follows the head frame, front/back resolves live.
3. Judge says the wearer's name → bubble anchored to the speaker's face with the transcribed text.
4. A phone plays a speech clip from off-screen → marker appears with **no face anchor**, labelled `playback`.
5. Smoke-alarm sound from a laptop → `urgent`, displaces everything, strip pulses.
6. Screens off: **the strip alone still shows direction.** (This is the accessibility shot.)
7. Title card with the §7.2.4 accuracy curve.

## 11. References

- Adafruit ICS-43434 breakout (PID 6049): pins, `SEL`, bottom-ported, 1.6–3.6 V — https://learn.adafruit.com/adafruit-i2s-mems-microphone-breakout/pinouts
- 24-bit left-justified-in-32-bit-slot detail (top 16 bits = int16) — https://learn.adafruit.com/i2s-microphones-with-circuitpython
- SoundWatch, ASSETS 2020 — smartwatch sound classification; **overload/filtering** findings: https://makeabilitylab.cs.washington.edu/project/soundwatch/
- HoloSound, ASSETS 2020 — AR HMD speech + sound ID for DHH: https://makeabilitylab.cs.washington.edu/project/holosound/
- HMD sound visualizations, CHI 2015: https://dl.acm.org/doi/abs/10.1145/2702123.2702393
- Prior projects we extend: **HearLink** (4× I2S mics, 2 buses, S3, necklace) https://devpost.com/software/hearlink · **echoBelt** (1st place, Hackaburg 2026) https://devpost.com/software/echobelt · **WhisperMap** https://devpost.com/software/whispermap · **N1 AR glasses** https://devpost.com/software/n1-augmented-relaity-sound-awareness-glasses · **Low-latency Sound Disambiguator** https://devpost.com/software/low-latency-sound-disambiguator
- YAMNet TFLite: https://tfhub.dev/google/lite-model/yamnet/classification/tflite/1

## 12. Traps, ranked by time cost

| Trap | Mitigation |
|---|---|
| ICS-43434 32-bit slot handling (`>> 16` for int16) | Do it in the first 20 minutes; validate with the RMS test before wiring all 4 mics |
| Bottom-ported mics mounted against fabric | Ports face away from the head; 5 mm standoff; foam windscreen |
| Servo/regulator transients injecting into the mic bus | Separate 5 V rail, common ground, no servo on the head |
| Two I2S buses drifting apart | One-time inter-bus offset via clap; re-check at 30 min (drift test) |
| Only one I2S port available (if the C3 is used) | Use the S3 for 4 mics; with one port, ship **2 mics** — azimuth still works |
| Reverberation wrecking TDOA | 300–6000 Hz band, SRP-PHAT, report honest `accuracy_deg` |
| Expo hall jams 2.4 GHz | **USB-CDC transport is the demo path**; WiFi is the "look, wireless" shot |
| Overload: the HUD becomes noise | Urgency tiers + `set_mode`, both in P1 |
| Camera needs HTTPS; iOS has no WebXR | localhost/self-signed cert; demo on Android Chrome or desktop |
| Four people editing one interface | §4 frozen; contract changes = README edit in the same commit |
| Assuming a model/venv/env "already exists" on some machine | Model file, loader code and venv are **repo artifacts** (§8). Nothing outside this repo is a dependency, and nothing on a personal machine counts as setup. |
