carn181/hackgt-26/site/og.png

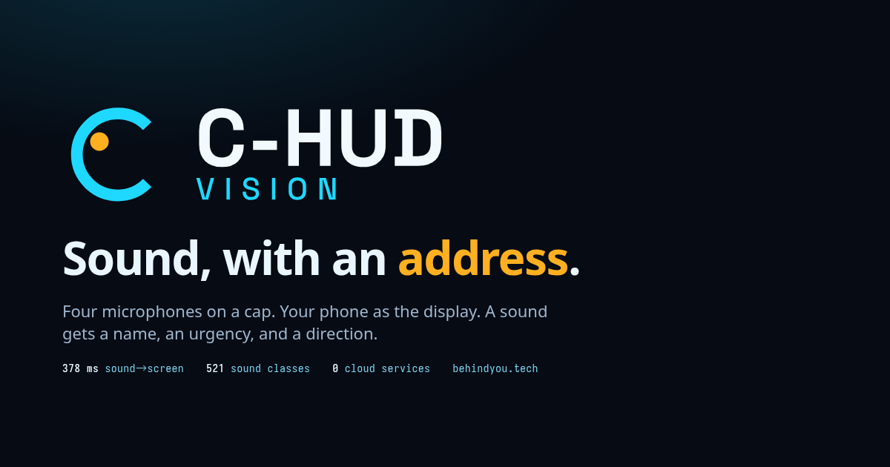
site/og.png
