carn181/hackgt-26/(commit log)

2026-09-26 Add README: architecture, frozen interfaces, per-stream agent briefs
    - Spatial sound-awareness HUD: bearing + class + camera overlay for DHH users
    - §4 freezes data contracts (UDP audio/telemetry, WS event schema, angle convention)
    - §6 gives each member a paste-ready agent brief with acceptance criteria
    - Documents verified YAMNet runner and NixOS loader workaround
2026-09-26 Re-base for ICS-43434 wearable cap: geometry, hat build, 20h plan
    - Hardware pinned: 4x Adafruit ICS-43434 on ESP32-S3 (2 I2S buses; C3 = 2 mics max)
    - ICS-43434 specifics: 32-bit slots, top 16 bits are int16, SEL=L/R, bottom-ported, 3.3V only
    - Form factor changed to head-worn: bearing is now measured in the HAT frame
    (frame-of-reference problem documented; LED strip = head-locked, screen-free output)
    - Array geometry: straight 240mm bar @ 80mm spacing -> 2.1kHz aliasing limit
    - Timeline re-based to Sat 10:35 with P0/P1/P2 scope ladder and cut order
    - USB-CDC transport added as the Expo insurance path (2.4GHz congestion)
    - config/array.json + config/calib.json created as the geometry/cali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
2026-09-26 Add per-owner progress checklist (section 0)
    - 49 evidence-based items: A hat/ESP32, B backend/models, C frontend, D integration
    - Hard gates G1-G5 wired to the real deadlines (14:30 CAD, 18:00 clap test, 01:00 accuracy,
    04:00 acceptance, 05:00 freeze)
    - Explicit agent protocol: tick only after running the evidence command, append owner+time,
    never uncheck/reword another owner's item, strike dropped items with a reason
    - Briefs now point at the checklist so acceptance criteria and checkboxes stay in sync
2026-09-26 Preflight the three toolchains; rebase timeline to 11:15
    - 8.6: node/npm present but no pio/arduino-cli/esptool/serial terminal; user not in dialout
    - Recorded install + serial-permission fixes so nobody loses an hour to it at 2am
    - Timeline header rebased 10:35 -> 11:15
2026-09-26 Add paste-ready session prompt for the frontend stream (C)
    - prompts/frontend.md: scope/ownership, verbatim WS contract, render rules incl. hat->hand
    frame conversion and the ambiguous-flag requirement, build order (mock server first),
    evidence requirements, and the checklist protocol
    - README 6.3 now points at it
2026-09-26 web: sound-awareness HUD — mock feed, canvas overlay, on-device faces
    Frontend deliverable (C, README §6.3 / prompts/frontend.md). Everything is under
    web/**; §4 of the README is untouched.
    - dev/mock-ws.mjs — scripted §4.5 stream on 127.0.0.1:8000/ws: the four demo
    beats, urgency-tier furniture, a moving id re-sent every 250 ms, timeline
    snapshots that update ids in place, MOCK-marked model/revision values, echoed
    `ping`, logged `set_mode`; geometry read from config/array.json.
    - Canvas 2D overlay (src/hud.ts, src/projection.ts) — frozen bearing→x mapping,
    edge chevrons outside the FOV instead of clamping, two mirrored candidates for
    ambiguous events, interpolated mark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
2026-09-26 README: how to run the HUD; tick frontend C1-C9 with their evidence
    - new §6.3.1 — mock + dev commands, laptop and phone paths, `?ws=` override, TLS
    env vars, the diagnostics chip, scripted debug hooks, what the mock replays,
    and the `npm run phone` certificate flow.
    - tick C1, C2, C4-C9 with the evidence actually observed (numbers and exact
    conditions in web/dev/evidence.md). C3 stays unchecked: it needs a human
    clapping at −40°/0°/+40° with a measured camera_fov_deg, which is not
    reproducible from a dev machine.
2026-09-26 backend: real ingest → DOA → YAMNet → fusion → WS (owner B)
    No ESP32 yet, so the pipeline runs on this laptop's 2-channel DMIC pair and the
    §4.2 packet path is verified without hardware. Swapping in the hat is
    `--profile hat --source auto` and nothing else.
    - server/: capture (pw/udp/serial/file) with a mandatory analysis band-pass,
    ring buffer, onset/offset detector, GCC-PHAT + SRP-PHAT with per-baseline
    aliasing limits and a coherence gate, YAMNet (§8.2), urgency tiers,
    faster-whisper ASR on a worker thread, camera-assisted bearing fusion
    (spacing auto-fit), FastAPI/WS service speaking §4.5/§4.6.
    - tools/: run_backend.sh (NixOS loader paths), udp_sniff.py (A5), latency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
    [asr.py, beam.py, calib_fit.py, classify.py, config.py, detect.py, doa.py, fuse.py]
2026-09-26 backend: dead-code sweep + profile-dependent coherence gate
    - Remove unused RingBuffer.t_us_of/seconds_available, Profile.accuracy_deg,
    DoaEstimate.resolved_by, parse_packet's t0_mono, and the stale ring.rate_hz.
    - Require gamma^2 >= 0.55 on an uncalibrated array (0.35 once a spacing has been
    measured): an unknown scale can be wrong in magnitude and direction, and one
    marginal live window had produced a -90.0 deg bearing. A genuine common source
    measures ~1.0, so the synthetic sweeps are unaffected (still 4/4 PASS).
    [config.py, doa.py, ingest.py, main.py, ring.py]
2026-09-26 backend: correct the capture-path diagnosis; verify the live speech path
    The previous revision claimed this laptop's DMIC capture was broken ("-15 dBFS junk,
    tones 50 dB down"). That was wrong: the measurement analysed the channel *mean* of a
    capture whose channel 1 carries a +5390 LSB DC offset and ~12 dB more LF energy, and
    the stimulus level was never verified. Measured properly:
    - DMIC is S32_LE @ 48 kHz; a speaker-played 650 Hz tone arrives at 41 dB in-band SNR,
    live speech classifies as Speech at 44.6 dB SNR, and ASR emits real transcripts.
    - The band-pass is still required, but for ch1's DC/LF (5.6 dB rise unfiltered vs 26 dB
    filtered), not because the mics are broken.
    - The genu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
    [fuse.py, main.py]
2026-09-26 backend: fix the detector release rule, gate ASR, cut classify latency
    Symptom report: "markers near my face sometimes, slow to classify, logs full of
    Silence, and events in the logs that never reach the HUD".
    Root cause of most of it: the onset detector closed a segment only when the level
    fell below floor+5 dB, which a live room whose level wanders +-6 dB around a floor
    estimated from its quietest frames never satisfies. One segment therefore stayed
    open until max_duration (12 s), and every real sound inside it was absorbed and
    classified against the room-bump window. Fixed by releasing on
    max(floor+5 dB, segment_peak-12 dB) -- quiet relative to its own peak, as a VAD
    does -- and max_dura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
    [asr.py, detect.py, fuse.py, main.py]
2026-09-26 backend+web: the HUD's microphone as a source (§4.6 `audio`)
    Lets a phone (or any browser) be the sensor when the laptop's DMIC pair is the weak
    part of the demo. The phone is not attached to the chassis, so a clap reaches it as
    airborne sound instead of a structural thump.
    - §4.6 `audio`: one 20 ms frame of 16 kHz mono PCM16 per message (base64 in JSON).
    The backend validates rate/channels/format against the live profile and drops
    mismatched frames with a counted warning.
    - server/ingest.py `BrowserSource`: frames arrive on the asyncio loop and reach the
    pipeline thread through a bounded queue (drop-oldest, never back-pressure the
    socket). It fills stream gaps with silence, which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
2026-09-26 backend: re-classify on the segment's loudest window; two new diagnostic tools
    The first classification runs 0.2 s after the onset, so its window is the segment's
    *head* — and when the onset lands on a pre-bump (a click, a table knock, a sink
    being unmuted) the head is not the sound. Measured by tools/speech_watch.py on live
    audio: the head window labelled an utterance Silence/Pig while the loudest window
    labelled it Speech, and the ASR gate then refused a good transcript.
    - On segment close the pipeline re-labels on the segment's loudest 0.975 s and
    re-sends the same event id only when the label is materially better, so the HUD
    updates in place. Live: `e4 Telephone 0.41 -> 0.92`, `e8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
2026-09-26 web+backend: the website's microphone is the default source
    - web: the HUD streams its own mic on load (no query param). `?mic=0` disables it,
    and a MICROPHONE button toggles it and shows `MIC ON · Ns` — getUserMedia needs a
    gesture on iOS, so the button is also the retry path. Verified with a real browser:
    `mic: running @ 16000 Hz`, 45 s streamed, frames reaching the backend.
    - backend: the default run is now `--profile browser_mono --source browser`, so a
    phone or a Mac becomes the sensor by opening the page.
    - server/beam.py: a profile may name `analysis_channels` (mic ids). The laptop
    stand-in needs it: both capsules are equally clean in-band (-57 dB in 300-3000 Hz)
    but ch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
2026-09-26 backend: report every event again — the suppression was chasing a faulty mic
    The gates (no-sound classes, confidence >= 0.30, segment SNR >= 12 dB) were added
    because the log filled with `Silence` events. That was the wrong diagnosis: the
    laptop's channel 1 carried a 36%-of-full-scale DC offset and a sub-100 Hz rumble
    31 dB above channel 0's, so the detector fired on room bumps and the classifier
    honestly answered "Silence". With a working microphone the events are real, and
    dropping them removes exactly what the system exists to show.
    - MIN_EVENT_SNR_DB, MIN_EVENT_CONFIDENCE and DROP_CLASSES now default to off
    (0.0 / 0.0 / empty), as do the ASR level gates. `--min-confidence` and the n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
    [fuse.py, main.py]
2026-09-26 models: commit yamnet.tflite + class map — both documented fetch URLs are dead
    README §8.1 says to commit the model if the fetch fails during the hackathon, because
    an unavailable model blocks three of four workstreams. It has: the tfhub.dev URL now
    returns 404 (verified with `curl -sIL`), and the storage.googleapis.com one returns
    403 as it always did. The class map still fetches from raw.githubusercontent.
    The two files are force-added past the `models/` gitignore rule (4.1 MB total), so a
    fresh clone plus `uv pip install -r requirements.txt` runs the backend with no
    network. sha256 of the committed tflite is 10c95ea3eb9a7bb4cb8bddf6feb0232…
    (the hash the classifier logs at startup).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
    [yamnet_class_map.csv]
2026-09-26 Merge reeves' frontend onto the backend branch (integration-reeves-frontend)
    Takes the frontend from origin/reeves wholesale, then re-applies only the two
    additive client messages the backend needs and fixes the handshake mismatch.
    Frontend (theirs): state/ws-client/calib/faces/render/validate replace the old
    hud.ts + projection.ts + vision.ts + vision.worker.ts + ws.ts, all deleted — they
    only referenced each other and their types no longer exist.
    - types.ts: added the §4.6 `vision` and `audio` messages, and made
    `audio_delay_ms` optional (the backend omits it until measured; validate.ts
    already defaults it to 0).
    - main.ts: sends `vision` frames from its own face detection at 10 Hz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
    [main.py]
2026-09-26 integration: restore the scripts, TLS and offline assets reeves' frontend dropped
    Three things the merge silently broke, found by testing the integrated branch:
    - web/package.json: reeves' version has only dev/build/preview, so `npm run phone`
    and `npm run mock` did not exist (and `npm run phone` failed with "Missing
    script"). Restored mock/phone/postinstall, keeping their dependency set.
    - web/vite.config.ts: theirs never read TLS_CERT_FILE/TLS_KEY_FILE, so
    `npm run phone` served plain HTTP — which looks fine until the phone silently
    refuses to hand over the camera and microphone, because getUserMedia needs a
    secure context. Grafted the TLS block in (both-or-neither, so a half-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
2026-09-26 three fixes: class probabilities in the log, a transcriber that stays current, no arrow pile-up
    1. **Class probabilities.** Every event line now prints the top-3 with YAMNet's
    own scores (`top: Speech 8% · Inside, small room 6% · Sound effect 4%`), and the
    message carries top-5 in `alternatives` so the HUD can show them too.
    `--log-classes N` changes the count.
    2. **Transcription was slow because the queue was saturated.** Removing the ASR
    gates (to stop suppressing events) let every speech-ish segment — including room
    noise the classifier guessed at — through to Whisper. Measured: 13
    `asr backlog: dropped a queued segment` warnings in 10 s, and
    `asr 0.83s audio i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
    [fuse.py, ingest.py, main.py]
2026-09-26 web: show non-speech events at full strength
    Non-speech was never filtered — it was dimmed into invisibility:
    - Marker opacity scaled straight by confidence, so anything under ~0.3 (most
    non-speech: `Sound effect 3%`, `Music 20%`) rendered at 0.2 alpha. It is now
    `age * clamp(0.65 + 0.35 * confidence, 0.65, 1)`: confidence still modulates, but
    a real detection never drops below 65% while it is alive.
    - `low` urgency was a grey-blue (#8aa0b4). Now #b9cbdd — the tier order stays
    obvious against normal/high/urgent, but every tier is legible.
    - The unlocalized caption list is more prominent too: 15px text, 22px rows, up to
    8 rows instead of 5, same opacity floor and the same urgen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
2026-09-26 web: mouth-activity detection is temporal, not a static threshold
    Bubble-anchoring and the §4.6 vision message's mouthActive flag were both
    keyed off jawOpen crossing a fixed threshold -- indistinguishable from a
    mouth just held open (smiling, resting) versus one actually articulating
    speech. Caught live with two real people in frame: the bubble consistently
    landed on whoever's mouth happened to be open, not whoever was talking.
    faces.ts now tracks each face's jawOpen score over a short rolling window
    (nearest-position matched across frames, since MediaPipe gives no
    persistent face id) and calls a face "active" only once that score has
    swung open-and-closed by a real margin recently -- a h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
2026-09-26 web: debounced speaker lock + stop defaulting bubbles to center
    Live two-person testing surfaced two related problems in bubble anchoring:
    1. Most segments arrive with no usable bearing at all (source: "none",
    accuracy_deg: 180 -- one mono mic can't localize), which fell through
    to an unanchored bubble at bearing 0 deg: dead center between two
    people, read as "it defaults to the center for no reason".
    2. Re-deciding "who's talking" from scratch on every segment made the
    bubble flip to whoever's mouth happened to be active at that instant,
    splitting one person's continuous sentence across both faces whenever
    the listener's mouth so much as flickered.
    Fixes both with one me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
2026-09-26 web: fix vision xc crop mismatch, add live mouth-activity diagnostics
    Confirmed bug: the §4.6 vision message sent MediaPipe's raw face
    coordinate (normalized to the full, uncropped video frame) as `xc`, but
    the backend's inverse projection assumes `xc` is normalized to the
    *visible, on-screen* frame -- which object-fit: cover crops before it
    ever reaches the screen. The client's own rendering already goes through
    this exact correction (computeCoverCrop/videoNormToCropNorm in calib.ts);
    the vision-sending code just wasn't using it, so every camera-derived
    bearing the backend computed was off by however much cropping was
    actually happening. Likely the direct cause of two live-tested symptoms: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
2026-09-26 web: rank mouth activity by oscillation, not amplitude
    Live edge case: one person opened his mouth much wider than the other,
    who was the one actually talking -- the bubble went to the wider mouth.
    Ranking by max-min swing rewards amplitude, and a single deliberate gape
    or yawn has a *larger* swing than real speech, which is smaller but rapid.
    Talking is oscillation, not amplitude: several open/close cycles a second.
    Replaced the swing measurement with a reversal count (how many times the
    jawOpen score changes direction within the rolling window, ignoring
    sub-threshold wobble as noise). A wide single gape now produces ~0-1
    reversals and a real talking mouth produces several within the same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
2026-09-26 web: phone orientation sensor for fluid, physically-panned bearings
    Adds src/orientation.ts: tracks the phone's own rotation via
    DeviceOrientationEvent (preferring iOS's webkitCompassHeading, falling
    back through deviceorientationabsolute to plain deviceorientation) as a
    delta since a reference sample -- never an absolute heading, since
    neither true-north referencing nor the rotation-sign convention can be
    verified without a real device.
    Feeds directly into head_yaw_offset_deg in main.ts's existing per-frame
    renderCalib, the same spot effectiveFovDeg already lives -- every marker,
    bubble, face-anchor match and the compass nose-marker already recomputes
    from calib every frame, so this is the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
2026-09-26 web: flip IMU rotation sign, stop resetting reference every 2s
    First real-device test: panning was backwards (turning left produced a
    positive delta; needed the opposite), and the tracked delta appeared to
    "reset to 0" whenever the phone stabilized. That second one wasn't really
    about stabilizing -- server/main.py re-broadcasts array_status every 2s
    regardless of whether anything changed (ARRAY_PERIOD_S), and the
    orientation reference was resetting on every single one of those, wiping
    an in-progress turn on a fixed timer rather than on an actual
    recalibration. Now only re-anchors when the received head_yaw_offset_deg
    value actually changes, or on the very first array_status.
2026-09-27 web: body-detection fallback for distant speakers, camera res + tap-focus
    Live testing at range (~1.5m+): FaceLandmarker can't resolve a face that
    small/far, so a speech bubble fell all the way through to the unanchored,
    center-defaulted style even though a real person was clearly visible and
    talking. @mediapipe/tasks-vision already ships PoseLandmarker (confirmed
    in the installed package, no new dependency) with the same
    createFromOptions/detectForVideo shape already used for faces --
    faces.ts now also runs pose detection (pose_landmarker_lite, fetched and
    committed the same way face_landmarker.task was) and derives an
    approximate head/neck bbox from BlazePose's nose/shoulder landmarks.
    mer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
2026-09-27 web: anchor to the only person in frame regardless of mouth data
    Live gap: body-only detection (too far for a face) has no mouth signal,
    so it could never win the speaker lock -- correct with a crowd, wrong
    when there's exactly one person and nothing to actually discriminate
    between. Speech now falls back to the sole detected person (face or
    body) when bearing and the lock both come up empty, rather than
    defaulting unanchored just because mouth-activity had nothing to say.
2026-09-27 hat: ESP32 direction-only firmware + web connect UI
    The 4-mic array's audio quality isn't good enough for speech/classification,
    so the ESP32 (single Arduino IDE sketch, no PlatformIO) now only reports
    which direction is loudest, gated by a slow-moving noise-floor baseline so
    room tone doesn't read as "someone calling." It broadcasts that over UDP
    (phone-hotspot WiFi, since venue/home networks tend to isolate clients or
    sit behind a captive portal) using the modern i2s_std driver so bus 1 can
    run as an I2S clock slave off bus 0's looped-back BCLK/WS.
    server/main.py relays the broadcast onto the existing WebSocket so the
    browser (no raw UDP) can see it. The web app gets a "connect" button
    (m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
    [hackgt_hat.ino, main.py]
2026-09-27 web: C-HUD Vision logo — dial mark + wordmark; real favicon
    - web/public/chud-logo.svg lockup for light backgrounds (transparent)
    - web/public/chud-logo-dark.svg reverse lockup for dark backgrounds
    - web/public/chud-logo.png 1200x800 raster, for the Devpost thumbnail
    - web/public/favicon.svg C-HUD mark on a plate (was the leftover Vite bolt)
    Mark: the letter C drawn as a bearing dial with the located source marked inside it.
    Wordmark: Space Grotesk (SIL OFL 1.1) converted to outlines, so the SVGs need no font
    at render time and carry no external references.
2026-09-27 docs: submission README (status + stack diagram + how to run); build spec moves to docs/SPEC.md
    The old README was a 755-line internal build spec — checklist, per-owner agent briefs,
    protocol tables, hour-by-hour plan, traps list. Excellent as a coordination document, wrong
    as the front door: a judge or a new teammate needs the first two minutes to land.
    - README.md (206 lines): pitch, per-feature shipped/partial/not-built table, tech-stack
    mermaid diagram, measured results with the exact command that produced each one, quickstart
    for the three processes, the wire-contract summary, limits, references, and the logo.
    - docs/SPEC.md: the previous README verbatim. Section numbers are unch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
2026-09-27 docs: README hero — the display is the phone, not a headset
    No AR/VR headset and no LED strip in the build, so "shown without asking them to look
    away" was the one line that overclaimed. The phone-in-pocket screen is the honest and
    stronger pitch: head-locked sensors, zero extra hardware.
2026-09-27 docs: 2-minute demo shoot script (beats, VO, sound menu, pre-roll checklist)
    docs/SPEC.md §10 was written before the hardware landed: its strip shot and its
    speaker-attribution beat are not shootable (no strip wired; attribution needs a face in
    frame and a transcript, and the evidence file already caveats it). This script is written
    against the shipped system and leads with what the hardware is actually good at —
    direction and urgency for environmental sound:
    - 9 beats in 2:00 with verbatim VO: a sound the phone can't place, the hat's own coarse
    quadrant for an off-camera source, an urgent alarm taking the screen, then the wearer
    filtering what may interrupt them.
    - Sound menu mapped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
2026-09-27 site: one-page summary for behindyou.tech (Pages, no build step)
    The written submission needs a landing page that survives after HackGT: what it is, what
    ships, how it works, the measured numbers with their commands, and what it explicitly does
    not do yet.
    - site/index.html — single self-contained page, dark HUD palette to match the app, inline
    logo (Space Grotesk outlines), CSS pipeline diagram of cap -> backend -> phone HUD. No JS,
    no CDN, no external fonts: the only request a visitor makes is the favicon.
    - site/og.png — 1200x630 card for the Devpost/Twitter preview; site/favicon.svg — the mark.
    - site/CNAME + .github/workflows/pages.yml — publishes site/ to GitHub Pages. The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
